StanislawStankiewicz/DefuseIt/thesis/thesis.pdf

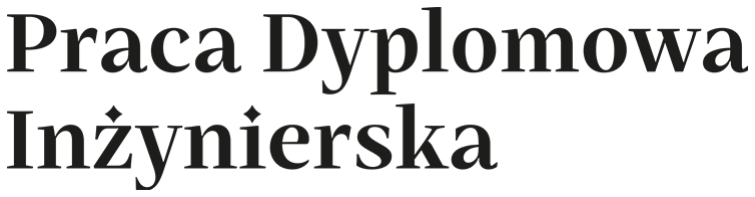
[picture p5: figure]

Stanisław Stankiewicz
217442

## Modularny system zadań logicznych zrealizowany w języku C++ dla mikrokontrolera ATmega328P

### Modular logic task system implemented in C++ language for the ATmega328P microcontroller

Praca dyplomowa na kierunku: Informatyka

Praca wykonana pod kierunkiem dra inż. Artura Wilińskiego Instytut Informatyki Technicznej Katedra Systemów Informatycznych

Warszawa, rok 2026

Oświadczenie Promotora pracy

Oświadczam, że niniejsza praca została przygotowana pod moim kierunkiem i stwierdzam, że spełnia ona warunki do przedstawienia tej pracy w postępowaniu o nadanie tytułu zawodowego.

Data | | Podpis promotora |

Oświadczenie autora pracy

Świadom/a odpowiedzialności prawnej, w tym odpowiedzialności karnej za złożenie fałszywego oświadczenia, oświadczam, że niniejsza praca dyplomowa została napisana przeze mnie samodzielnie i nie zawiera treści uzyskanych w sposób niezgodny z obowiązującymi przepisami prawa, w szczególności z ustawą z dnia 4 lutego 1994 r. o prawie autorskim i prawach pokrewnych (Dz. U. 2019 poz. 1231 z późn. zm.)

Oświadczam, że przedstawiona praca nie była wcześniej podstawą żadnej procedury związanej z nadaniem dyplomu lub uzyskaniem tytułu zawodowego.

Oświadczam, że niniejsza wersja pracy jest identyczna z załączoną wersją elektroniczną. Przyjmuję do wiadomości, że praca dyplomowa poddana zostanie procedurze antyplagiatowej.

Data | | Podpis autora pracy |

Streszczenie

Tematem pracy jest zaprojektowanie i implementacja modułowego sys-

temu interaktywnych zadań logicznych opartego na mikrokontrolerach

ATmega328P. Projekt zakładał stworzenie systemu wbudowanego sty-

mulującego współpracę grupy użytkowników rozwiązujących powiązane

zagadki pod presją czasu. Architektura umożliwia dowolną konfigurację

oraz łatwe rozszerzanie układu o kolejne niezależne moduły. Praca obej-

muje fazę koncepcyjną, projektowanie sprzętowe, implementację protokołu komunikacyjnego I²C oraz integrację oprogramowania w języku C++.

Wyniki testów wskazują, że zaimplementowane podsystemy działają sta-

bilnie, a przyjęta sieć Nadrzędny-Podrzędny (ang. Master-Slave) zapew-

nia skalowalność środowiska.

modułowy system wbudowany, C++, I2C, ATmega328P, praca inżynierska, SGGW

Słowa kluczowe – Modular logic task system implemented in C++ language for the

ATmega328P microcontroller

Summary

The subject of this thesis is the design and implementation of a modular

system of interactive logic tasks based on ATmega328P microcontrollers.

The project involved creating an embedded system that stimulates the

cooperation of a group of users solving interrelated puzzles under time

pressure. The system architecture was planned to allow for arbitrary con-

figuration and easy expansion with additional independent modules. The

thesis covers the conceptual phase, hardware design, implementation of a communication protocol based on the I²C bus, and software integration in

C++. Validation test results indicate that the implemented subsystems

exhibit stable operation, and the adopted Master-Slave network ensures

scalability of the environment.

embedded system, C++, I2C, ATmega328P, engineering thesis, WULS

Keywords –

# Spis treści

1 Wstęp | 9
2 Narzędzia i użyte technologie | 12
3 Projekt systemu zadań logicznych | 17
3.4.3 | Diagram klas warstwy sprzętowej i bibliotek zewnętrznych . . 24
4 Implementacja systemu | 26

5 Testy i działanie systemu | 47
6 Podsumowanie i wnioski końcowe | 52
Bibliografia | 54
Spis rysunków | 56
Spis tabel | 57

# 1 Wstęp

Wraz z dynamicznym rozwojem systemów wbudowanych (ang. embedded systems)

oraz postępującą miniaturyzacją sprzętu elektronicznego mikrokontrolery stały się

powszechnie dostępne dla szerokiego grona inżynierów i konstruktorów. Umożliwia-

ją one projektowanie zaawansowanych, interaktywnych urządzeń fizycznych, które

wymagają od użytkownika logicznego myślenia oraz szybkiego podejmowania decy-

zji. Istniejące na rynku rozwiązania komercyjne (wykorzystywane m.in. w pokojach

zagadek typu escape room lub w celach edukacyjno-szkoleniowych) rzadko jednak

oferują otwartą i modularną architekturę opartą na tanich, 8-bitowych mikrokon-

trolerach tworzących skalowalną sieć. Z tego powodu podjęto próbę konstrukcji au-

torskiej platformy.

## 1.1 Cel pracy

Głównym celem niniejszej pracy jest zaprojektowanie architektoniczne oraz wdroże-

nie modularnego systemu zadań logicznych. System wymusza równoległe rozwiązy-

wanie różnorodnych procedur zadaniowych przez wielu uczestników w wyznaczonym

czasie. Rozwiązanie opiera się na zdecentralizowanych interfejsach wejściowych oraz

centralnym nadzorze jednostki zarządzającej.

Temat wybrano w celu weryfikacji zagadnień związanych z programowaniem

8-bitowych mikrokontrolerów rodziny AVR, w szczególności układu ATmega328P

[1], integracją układów elektronicznych oraz implementacją niezawodnej komuni-

kacji między modułami. Konstrukcja systemu czasu rzeczywistego (ang. real-time

system) stanowi złożone zagadnienie techniczne. Wymagała ona m.in. zbudowania

warstwy transportowej opartej na magistrali I²C w celu zapewnienia bezkolizyjnej

wymiany danych pomiędzy jednostką nadrzędną, zarządzającą logiką gry, a nieza-

leżnymi węzłami wykonawczymi. Ze względu na specyfikę projektu konieczna była

optymalizacja kodu C++ pod kątem ograniczonej pamięci SRAM, której pojemność

w układach ATmega328P wynosi 2 KB.

## 1.2 Analiza istniejących rozwiązań

Projektowany system czerpie inspirację z popularnej gry kooperacyjnej Keep Talking

and Nobody Explodes, w której gracze muszą wspólnie rozbroić ładunek, komunikując

się i rozwiązując zagadki logiczne. Na rynku istnieją również komercyjne platformy

dla pokoi zagadek (np. Escape Room Master), oferujące gotowe sterowniki i oprogra-

mowanie. Jednak większość tych rozwiązań opiera się na drogich sterownikach PLC

lub mikrokomputerach typu Raspberry Pi. Niniejsza praca udowadnia, że podobną

funkcjonalność można osiągnąć przy użyciu znacznie tańszych i bardziej energoosz-

czędnych 8-bitowych mikrokontrolerów, zachowując przy tym pełną modularność i

łatwość rozbudowy.

Dodatkową wartością zaproponowanego rozwiązania jest połączenie kilku mecha-

nizmów rzadko występujących łącznie w prostych systemach AVR: automatycznego wykrywania modułów na magistrali I²C, globalnej deterministycznej konfiguracji

scenariusza gry (seed), propagacji liczby błędów do wszystkich węzłów oraz odpor-

nej na przypadkowe wyzwolenie procedury restartu.

## 1.3 Zakres pracy

Niniejsza praca inżynierska obejmuje pełen cykl projektowy i programistyczny – od

zaplanowania architektury systemu i opracowania algorytmiki oprogramowania aż

do ostatecznych testów stabilności. Wyszczególniony wykaz obszarów zadaniowych

zrealizowanych w ramach niniejszej pracy obejmuje:

- opracowanie koncepcji sprzętowej i programowej topologii rozproszonej typu

Master-Slave, wykorzystującej mikrokontrolery ATmega328P [1],

- wdrożenie biblioteki ModuleComms opartej na protokole I²C, obsługującej au-

tomatyczne wykrywanie modułów na magistrali (tzw. skanowanie adresów),

- zaprogramowanie stacji Master, odpowiedzialnej za odliczanie czasu przy uży-

ciu wielozadaniowości asynchronicznej oraz odbieranie informacji o stanie za-

dań z modułów,

- zaprogramowanie w języku C++ modułów: arytmetycznego, labiryntu (wy-

świetlacz OLED), radiowego (dekodowanie alfabetu Morse’a), sekwencyjnego

oraz modułu z przełącznikiem dźwigniowym,

- optymalizację użycia pamięci SRAM poprzez wykorzystanie pamięci Flash

(dyrektywa PROGMEM) do przechowywania danych statycznych,

- realizację testów z uwzględnieniem sprzętowej i programowej eliminacji drgań

styków (ang. debouncing).

Tak zdefiniowany zakres porządkuje dalszą strukturę pracy: w kolejnym rozdziale

przedstawiono technologie i biblioteki wykorzystane w projekcie, następnie omówio-

no założenia projektowe, implementację oraz wyniki testów.

# 2 Narzędzia i użyte technologie

W niniejszym rozdziale przedstawiono technologie, narzędzia oraz biblioteki wyko-

rzystane w niniejszej pracy. Dla każdego komponentu opisano jego rolę oraz sposób

wykorzystania. Realizacja pracy opierała się na sprawdzonych rozwiązaniach otwar-

toźródłowych (ang. open-source), co pozwoliło skupić się na logice gry zamiast na

tworzeniu sterowników od podstaw.

## 2.1 Mikrokontroler ATmega328P

ATmega328P [1] to 8-bitowy mikrokontroler z rodziny AVR, posiadający 32 KB

pamięci programu (Flash), 2 KB pamięci operacyjnej (SRAM) oraz 1 KB pamięci

danych (EEPROM). Dzięki architekturze RISC większość instrukcji wykonuje w

jednym cyklu zegara, co zapewnia dobrą wydajność przy niskim poborze energii.

Wybór tego układu podyktowany był trzema czynnikami. Po pierwsze, stanowi

on fundament popularnej platformy Arduino Uno, co daje dostęp do bardzo dużej

liczby bibliotek oraz materiałów edukacyjnych. Po drugie, oferuje natywną obsługę

peryferiów pracujących w standardzie 5 V, co eliminuje potrzebę stosowania konwerterów napięć. Po trzecie, posiada sprzętowy kontroler I²C (TWI), który jest

fundamentem komunikacji w tym systemie.

W niniejszej pracy układy pracują pod kontrolą wewnętrznego oscylatora RC

skonfigurowanego na częstotliwość 8 MHz. Wykorzystanie wbudowanego źródła sy-

gnału zegarowego, zamiast zewnętrznego rezonatora kwarcowego dostarczającego

sygnał taktujący, obniża złożoność i koszt obwodu, a jednocześnie pozwala na pra-

cę w poszerzonym zakresie napięć zasilania od 2.7 V do 5.5 V. Choć wbudowany

oscylator charakteryzuje się tolerancją wahań do ±10% (w stałych warunkach po-

kojowych błąd oscyluje w granicach ±1–2%), odchylenia te są pomijalne w kon-

tekście działania gry oraz obsługi magistrali I²C. Konfigurację niskopoziomową mi-

krokontrolera (ustawienie bitów konfiguracyjnych (ang. fuse bits), odpowiedzialnych

za trwałe ustawienia sprzętowe układu) przeprowadzono bezpośrednio przy użyciu

narzędzia wiersza poleceń avrdude, co umożliwiło precyzyjne sterowanie parame-

trami pracy układu bez użycia dodatkowych nakładek systemowych. Bezpośrednie wgrywanie oprogramowania przez złącze programowania wewnątrzsystemowego

(ang. In-System Programming — ISP) pozwoliło całkowicie wyeliminować program

rozruchowy (ang. bootloader), dzięki czemu kod programu ma do dyspozycji pełne

32 KB pamięci Flash. Jest to istotna optymalizacja względem standardowej plat-

formy Arduino Uno, w której część pamięci programu stale zajmuje wspomniany

program rozruchowy.

## 2.2 Środowisko Arduino IDE

Arduino IDE [2] to środowisko programistyczne ułatwiające tworzenie oprogramowa-

nia na mikrokontrolery. Pozwala na pisanie kodu w C++ z wykorzystaniem gotowych

bibliotek obsługujących m.in. przerwania czy komunikację.

Wybór Arduino IDE, zamiast alternatyw takich jak PlatformIO czy Atmel Stu-

dio, podyktowany był przede wszystkim dojrzałością ekosystemu bibliotek kompa-

tybilnych z platformą AVR oraz niskim progiem wejścia przy prototypowaniu. Choć

PlatformIO oferuje bardziej zaawansowane zarządzanie zależnościami, Arduino IDE

zapewniło wystarczającą funkcjonalność przy jednoczesnej prostocie konfiguracji

wielomodułowego projektu.

W ramach niniejszej pracy proces programowania układów realizowano za po-

średnictwem wspomnianego wcześniej narzędzia avrdude oraz zewnętrznego progra-

matora sprzętowego USBasp. Na potrzeby seryjnego przygotowania mikrokontrole-

rów opracowano dedykowany adapter wyposażony w gniazdo typu ZIF (ang. Zero

Insertion Force) z mechanizmem dźwigniowym. Rozwiązanie to umożliwiło szybką i

bezpieczną wymianę układów brzegowych bez ryzyka uszkodzenia ich wyprowadzeń,

zapewniając stabilne połączenie z programatorem.

## 2.3 Biblioteka komunikacji I²C – Wire.h

Wire.h [4] jest standardową biblioteką środowiska Arduino, realizującą obsługę pro-

tokołu I²C (Inter-Integrated Circuit) za pośrednictwem wbudowanego sprzętowego

kontrolera TWI mikrokontrolera ATmega328P. Biblioteka przejmuje zarządzanie re-

jestrami taktowania przesyłu, przerwaniami oraz identyfikacją sprzętową sygnałów

potwierdzających komunikację (ACK/NACK).

Protokół I²C został wybrany jako magistrala komunikacyjna systemu ze względu

na minimalizację liczby wymaganych połączeń sygnałowych — do połączenia dowolnej liczby urządzeń wystarczają zaledwie dwie linie sygnałowe (SDA i SCL) oraz

wspólne zasilanie. W porównaniu z alternatywami, takimi jak SPI (wymagający do-

datkowej linii CS dla każdego urządzenia) czy UART, I²C stanowi optymalny kom-

promis między prostotą połączeń a skalowalnością. Co istotne, protokół UART jest

interfejsem asynchronicznym, co przy braku zewnętrznego oscylatora kwarcowego i

pracy na wewnętrznym oscylatorze RC mogłoby prowadzić do błędów synchronizacji ramek przy wahaniach temperatury. Magistrala I²C, jako interfejs synchroniczny

(wykorzystujący linię zegarową SCL), jest niewrażliwa na niedokładności taktowania

mikrokontrolerów.

W niniejszej pracy biblioteka Wire.h stanowi fundament autorskiej biblioteki

ModuleComms, realizując fizyczną warstwę transportową komunikacji między jed-

nostką Master a modułami Slave.

## 2.4 Biblioteki graficzne Adafruit

Rodzina bibliotek Adafruit obejmuje Adafruit_GFX [6] — uniwersalny rdzeń gra-

ficzny 2D — oraz Adafruit_SH110X [5] — dedykowany sterownik dla wyświetlaczy

OLED opartych na układzie SH1106G.

Biblioteki te wybrano ze względu na ich szeroką kompatybilność z ekosystemem

Arduino, aktywne wsparcie społeczności oraz zoptymalizowane algorytmy rysowa-

nia, dostosowane do ograniczeń pamięciowych mikrokontrolerów 8-bitowych. Alter-

natywna biblioteka U8g2lib, choć oferuje podobną funkcjonalność, wykazuje więk-

sze zapotrzebowanie na pamięć SRAM, co stanowi istotne ograniczenie na platformie

ATmega328P dysponującej zaledwie 2 KB tego zasobu.

W niniejszej pracy biblioteki Adafruit wykorzystano w modułach labiryntu oraz

radiowym do obsługi monochromatycznych wyświetlaczy OLED o rozdzielczości

128x64 pikseli. Warstwa Adafruit_GFX umożliwia rysowanie prymitywów graficz-

nych (prostokątów, okręgów, glifów tekstowych) oraz renderowanie bitmap przecho-

wywanych w pamięci Flash za pośrednictwem dyrektywy PROGMEM, co pozwala na

obsługę dużych zasobów graficznych bez obciążania ograniczonej pamięci SRAM.

## 2.5 Biblioteka wyświetlacza LiquidCrystal

Biblioteka LiquidCrystal [3] jest standardowym narzędziem środowiska Arduino

służącym do obsługi wyświetlaczy alfanumerycznych opartych na sterowniku Hitachi HD44780. Pozwala ona na komunikację z panelem LCD w trybie 4-bitowym lub

8-bitowym, co umożliwia elastyczne zarządzanie zasobami sprzętowymi mikrokon-

trolera.

W niniejszej pracy wykorzystano tryb 4-bitowy, który wymaga podłączenia sze-

ściu linii sygnałowych (RS, EN oraz cztery linie danych). Choć rozwiązanie to zaj-

muje więcej pinów mikrokontrolera niż alternatywne interfejsy szeregowe, zapewnia

ono najwyższą wydajność odświeżania oraz pełną kompatybilność z podstawowymi

bibliotekami bez konieczności stosowania dodatkowych układów pośredniczących, takich jak ekspandery I²C. Wybór ten był możliwy dzięki rezygnacji z innych pe-

ryferiów w module arytmetycznym, co pozostawiło wystarczającą liczbę wolnych

wyprowadzeń ATmega328P. W ramach niniejszej pracy biblioteka służy do wyświe-

tlania treści zadań matematycznych oraz wprowadzanych przez użytkownika odpo-

wiedzi na panelu LCD 16x2.

## 2.6 Biblioteka TM1637Display

TM1637Display [7] jest biblioteką obsługującą sprzętowy sterownik TM1637, stoso-

wany w poczwórnych wyświetlaczach 7-segmentowych. Sterownik ten wykorzystuje dwuprzewodowy protokół komunikacyjny zbliżony koncepcyjnie do I²C, lecz wyma-

gający dedykowanych linii CLK i DIO.

Decyzja o zastosowaniu wyświetlacza TM1637 w jednostce nadrzędnej, zamiast

np. wyświetlacza OLED, podyktowana była niskim kosztem komponentu, doskona-

łą czytelnością dużych cyfr z dalszej odległości oraz minimalnym zapotrzebowaniem

na zasoby mikrokontrolera. Biblioteka realizuje transmisję danych bez stosowania

blokujących opóźnień typu delay(), co jest kluczowe dla zachowania ciągłości asynchronicznego nasłuchu na magistrali I²C w pętli głównej programu.

W niniejszej pracy wyświetlacz TM1637 pełni rolę głównego wskaźnika upływa-

jącego czasu gry w formacie MM:SS, informując uczestników o zbliżającym się jego

końcu.

## 2.7 Biblioteka interfejsu SPI

SPI.h jest standardową biblioteką środowiska Arduino, realizującą obsługę protoko-

łu Serial Peripheral Interface (SPI). Interfejs ten umożliwia szybką, synchroniczną

komunikację szeregową z peryferiami za pośrednictwem czterech linii sygnałowych:

MOSI (Master Out Slave In), MISO (Master In Slave Out), SCK (Serial Clock)

oraz CS (Chip Select).

Protokół SPI został zastosowany w module labiryntu zamiast I²C z dwóch klu-

czowych powodów. Po pierwsze, magistrala SPI oferuje znacząco wyższą przepusto-

wość, niezbędną do wydajnego przesyłania pełnych buforów ramki obrazu (1 KB) do

wyświetlacza OLED bez blokowania pętli głównej. Po drugie, mikrokontrolery ATmega328P posiadają tylko jeden sprzętowy interfejs I²C, który w tym module jest

już wykorzystywany do pracy w trybie Slave na potrzeby komunikacji systemowej.

Jednoczesna obsługa wyświetlacza jako Master na tej samej magistrali byłaby pro-

gramowo i sprzętowo nieefektywna, wymagając ciągłego i ryzykownego przełączania

trybów pracy kontrolera TWI.

# 3 Projekt systemu zadań logicznych

W niniejszym rozdziale przedstawiono projekt modularnego systemu zadań logicz-

nych. Głównym celem projektu było opracowanie skalowalnej i łatwej w rozszerzaniu

platformy sprzętowo-programowej, umożliwiającej jednoczesną, interaktywną pracę

wielu uczestników z niezależnymi modułami zagadek, koordynowanymi przez cen-

tralną jednostkę zarządzającą. W kolejnych podrozdziałach szczegółowo opisano spe-

cyfikację wymagań, architekturę systemu oraz strukturę klas obiektowych.

## 3.1 Specyfikacja wymagań

Kluczowym etapem projektu jest określenie wymagań, które system musi spełniać.

Na podstawie analizy problemu, przeglądu podobnych rozwiązań (np. w pokojach

zagadek typu escape room) oraz ograniczeń mikrokontrolerów AVR, wyodrębniono

wymagania funkcjonalne i niefunkcjonalne.

### 3.1.1 Wymagania funkcjonalne

Wymagania funkcjonalne definiują zakres operacji i możliwości, które system musi

dostarczyć użytkownikowi końcowemu. Kluczowe funkcje realizowane przez projek-

towany system zostały zestawione w Tabeli 3.1.

Tabela 3.1. Wymagania funkcjonalne systemu

Numer | Nazwa | Opis
WF-01 | Koordynacja czasu rozgrywki | Centralny węzeł Master zarządza odliczaniem czasu dla wszystkich modułów. Błędy popeł-niane przez graczy powodują przyspieszenie odliczania czasu.
WF-02 | Niezależna logika modułów zagadek | Każdy moduł posiada własny algorytm roz-wiązywania, a komunikacja z jednostką nad-rzędną odbywa się wyłącznie na żądanie węzła głównego.

Kontynuacja na następnej stronie

Tabela 3.1 – kontynuacja z poprzedniej strony

Numer | Nazwa | Opis
WF-03 | Determinizm konfi-guracji (Seed) | System inicjuje przed startem dystrybucję glo-balnego numeru konfiguracji po łączu I²C, de-terminując pseudolosowe zdarzenia we wszyst-kich układach.
WF-04 | Obsługa wielu typów modułów | System obsługuje co najmniej pięć typów mo-dułów: arytmetyczny, labiryntu, radiowy, se-kwencyjny oraz z przełącznikiem.
WF-05 | Detekcja i propaga-cja błędów | Niepoprawne działanie użytkownika generuje zdarzenie błędu rejestrowane globalnie przez Master. Akumulacja błędów wpływa na za-chowanie pozostałych modułów.
WF-06 | Automatyczne wy-krywanie topologii | Serwer Master po uruchomieniu skanuje adre-sy magistrali I²C w celu automatycznej iden-tyfikacji podłączonych modułów bez ręcznej konfiguracji.
WF-07 | Sygnalizacja dźwię-kowa i wizualna | System zapewnia eskalujące ostrzeżenia dźwiękowe oraz wizualne informujące o zbli-żającym się końcu limitu czasowego oraz o stanie błędu.
WF-08 | Mechanizm restartu z zabezpieczeniem | Restart gry wymaga trzykrotnej aktywa-cji przełącznika w ustalonym oknie czaso-wym, zapobiegając przypadkowemu zreseto-waniu rozgrywki.

Zdefiniowane wymagania kładą nacisk na samodzielność modułów przy central-

nej koordynacji. Obejmują one mechanizmy zarządzania rozgrywką (odliczanie cza-

su, błędy) oraz funkcje systemowe, takie jak automatyczne wykrywanie modułów

czy konfiguracja gry za pomocą ziarna (ang. seed).

### 3.1.2 Wymagania niefunkcjonalne

Wymagania niefunkcjonalne definiują cechy jakościowe systemu oraz techniczne ogra-

niczenia projektu. Kluczowe wymagania z tej kategorii zestawiono w Tabeli 3.2.

Tabela 3.2. Wymagania niefunkcjonalne systemu

Numer | Nazwa | Opis
WN-01 | Modularność sprzę-towa (Plug-and-Play) | Stacje podłączane są do wspólnej szyny I²C na współdzielonym zasilaniu (+5 V i GND), co ogranicza liczbę połączeń montażowych i zwiększa odporność na chwilowe przerwy w łączności.
WN-02 | Wielozadaniowość nieblokująca | Rezygnacja z wywołań delay() w logice rdze-niowej. Ocena stanów opiera się na obliczaniu różnicy czasu z wykorzystaniem systemowego stopera millis().
WN-03 | Efektywne wykorzy-stanie pamięci | System funkcjonuje w ramach limitów AT-mega328P (2 KB SRAM, 32 KB Flash). Du-że struktury danych alokowane są w pamięci Flash za pośrednictwem PROGMEM.
WN-04 | Skalowalność | Architektura umożliwia rozszerzenie o dodat-kowe moduły bez modyfikacji oprogramowa-nia Master (do 126 urządzeń na magistrali 2C). I
WN-05 | Niezawodność komu-nikacji | Protokół transportowy jest odporny na chwi-lowe zaniki łączności z pojedynczymi modu-łami bez destabilizacji pracy pozostałych wę-złów.
WN-06 | Koszt i dostępność komponentów | Projekt bazuje na tanich, powszechnie dostęp-nych komponentach elektronicznych w celu ograniczenia kosztów produkcji prototypu.
WN-07 | Stabilność zasilania | System funkcjonuje w zakresie napięć 2.7– 5.5 V, wykorzystując wewnętrzny oscylator RC 8 MHz z tolerancją wahań ±1–2%.

Wymagania te stawiają priorytet na wielozadaniowość oraz optymalizację pa-

mięci — co jest krytyczne przy zaledwie 2 KB pamięci SRAM. Istotna jest także

modularność typu Plug-and-Play, pozwalająca na dowolne podłączanie modułów

bez zmian w oprogramowaniu sterownika głównego.

## 3.2 Architektura systemu

System oparto na architekturze nadrzędno-podrzędnej (ang. Master-Slave), gdzie

centralna jednostka koordynuje pracę modułów przez magistralę I²C (Inter-Integrated

Circuit). Jest to szeregowy interfejs komunikacyjny wykorzystujący dwie linie sy-

gnałowe: SDA (Serial Data) do przesyłu danych oraz SCL (Serial Clock) do syn-

chronizacji zegarowej. Wybór tej magistrali podyktowany był jej oszczędnością w

liczbie wymaganych połączeń oraz natywnym wsparciem przez sprzętowy kontroler

TWI (Two Wire Interface) mikrokontrolera ATmega328P [1]. Zastosowanie języka

C++ pozwoliło na programowanie obiektowe z pełną kontrolą nad alokacją pamięci.

Biblioteka ModuleComms zarządza komunikacją na niskim poziomie, wykorzystując sprzętowy protokół I²C. Master inicjuje zapytania i przesyła informacje o czasie

czy błędach, natomiast klasa Slave automatycznie obsługuje te żądania po stronie

modułów. Dzięki zastosowanej abstrakcji programista modułu nie musi zajmować

się obsługą magistrali, co pozwala skupić się na samej logice zagadki. Wyróżnia się

trzy główne fazy pracy systemu:

1. Faza wykrywania (ang. Discovery): Wywołanie pętli wysyłkowej z ko-

mendą 0x07 (CMD_IDENTIFY), skanującej adresy od 1 do 126 z zapytaniem o

rzetelną odpowiedź ACK sprzętu.

2. Faza propagacji i rejestracji startu (ang. Propagation and Start):

Przeprowadzenie inicjacyjnej transakcji rozgłaszanej z flagą CMD_START_GAME.

3. Faza testowania cyklicznego stanu (ang. Run Loop): Ciągłe odpytywa-

nie modułów o ich stan logiczny, przechwytywanie zdarzeń błędu i sukcesu.

## 3.3 Konstrukcja i montaż modułów

Ważnym aspektem projektu była integracja komponentów elektronicznych w działa-

jące moduły. Każda stacja została przygotowana w sposób umożliwiający testowanie

i weryfikację założeń projektowych. Wszystkie połączenia krytyczne (zasilanie, ma-

gistrala I²C) zostały wykonane w sposób zapewniający stabilność komunikacji.

W procesie realizacji skupiono się na:

- Przygotowaniu stanowisk: Przyciski, enkoder oraz wyświetlacze zostały

połączone z mikrokontrolerami zgodnie z opracowanymi schematami.

- Zasilaniu: Całość systemu zasilana jest napięciem 5 V ze wspólnego źródła, co zapewnia kompatybilność z mikrokontrolerami ATmega328P.
- Integracji peryferiów: Każdy moduł posiada dedykowany zestaw elementów

(np. matryce LED, ekrany LCD/OLED) ściśle współpracujących z warstwą

oprogramowania.

## 3.4 Diagramy klas

W niniejszej sekcji przedstawiono diagramy klas dokumentujące strukturę obiektową

zaprojektowanego systemu. Diagramy opracowano zgodnie z notacją UML 2.0.

### 3.4.1 Diagram klas biblioteki ModuleComms

W celu sformalizowania struktury oprogramowania oraz ułatwienia procesu imple-

mentacji, posłużono się notacją UML (Unified Modeling Language). Diagram klas

jest diagramem strukturalnym, przedstawiającym system za pomocą wizualizacji

atrybutów, metod oraz relacji pomiędzy klasami. Jest on powszechnie stosowanym

narzędziem w projektowaniu systemów opartych na programowaniu obiektowym.

Centralnym elementem architektury komunikacyjnej jest autorska biblioteka

ModuleComms, której strukturę obiektową przedstawiono na Rysunku 3.1. Diagram

prezentuje dwie główne klasy — Master oraz Slave — wraz z typami pomocniczymi

definiującymi protokół komunikacyjny.


Rysunek 3.1. Diagram klas biblioteki ModuleComms — relacja Master-Slave z protokołem komunikacyjnym (opracowanie własne)

Diagram klas przedstawia strukturę autorskiej biblioteki komunikacyjnej, w tym

klasy Master (odpowiadającą za jednostkę nadrzędną) oraz Slave (reprezentującą

podległe moduły), a także powiązane z nimi typy wyliczeniowe Protocol i Status.

Implementacja wykorzystuje mechanizm wstrzykiwania funkcji zwrotnych (wskaź-

niki GameLoop i ResetState), co pozwala na pełną separację warstwy sieciowej od

logiki biznesowej konkretnych zadań. Metoda getModuleStatus() umożliwia odczyt

stanu poszczególnych węzłów.

Klasa Slave reprezentuje stronę odbiorczą protokołu. Wykorzystuje statyczne

pola i metody ze względu na ograniczenia biblioteki Wire.h, która wymaga rejestra-

cji funkcji zwrotnych w postaci wskaźników na funkcje wolnostojące. Wstrzykiwanie

logiki gry odbywa się przez wskaźniki funkcyjne GameLoop oraz ResetState, prze-

kazywane w konstruktorze — stanowi to realizację wzorca odwrócenia sterowania

(ang. Inversion of Control), umożliwiającą każdemu modułowi zagadki dostarczenie

własnej implementacji pętli gry bez modyfikacji kodu biblioteki komunikacyjnej.

Typy wyliczeniowe Protocol oraz Status definiują zestaw jednobajtowych kodów operacyjnych (opcodes) przesyłanych na magistrali I²C, zapewniając jedno-

znaczną interpretację ramek komunikacyjnych po obu stronach łącza.

### 3.4.2 Diagram klas modułów zagadek

Każdy moduł zagadki w systemie stanowi niezależną jednostkę logiczną, integrowaną

z magistralą komunikacyjną poprzez instancję klasy Slave z biblioteki ModuleComms.

Diagram przedstawiony na Rysunku 3.2 ilustruje strukturę pięciu zaimplementowa-

nych modułów wraz z ich wewnętrznymi typami danych.


Rysunek 3.2. Diagram klas modułów zagadek z wewnętrznymi typami wyliczeniowymi i strukturami danych (opracowanie własne)

Wspólnym elementem architektury wszystkich modułów jest mechanizm wstrzy-

kiwania funkcji zwrotnych (ang. callbacks) — każdy moduł przekazuje w konstruk-

torze klasy Slave wskaźniki na swoje funkcje gameLoop() oraz resetState(), re-

alizując wzorzec odwrócenia sterowania (ang. Inversion of Control). Dzięki temu

klasa Slave wywołuje logikę specyficzną dla danego modułu bez znajomości jej im-

plementacji.

Moduły różnią się znacząco pod względem złożoności wewnętrznej. Moduł se-

kwencyjny wykorzystuje maszynę stanów (enum GameState) do zarządzania fa-

zami rozgrywki, natomiast moduł z przełącznikiem operuje na typach wyliczenio-

wych ActionType i ColorId definiujących logikę decyzyjną opartą na kolorze diody

RGB i numerze wersji gry. Moduł arytmetyczny implementuje dwa tryby pracy

(enum Mode: arytmetyczny i binarny), a moduł radiowy przechowuje tablicę struk-

tur RadioTarget z częstotliwościami i kodami Morse’a w pamięci Flash (PROGMEM).

### 3.4.3 Diagram klas warstwy sprzętowej i bibliotek zewnętrz-

### nych

Ostatni z diagramów (Rysunek 3.3) przedstawia mapę zależności pomiędzy moduła-

mi systemu a wykorzystywanymi bibliotekami zewnętrznymi. Diagram uwidacznia,

w jaki sposób poszczególne węzły korzystają ze współdzielonych komponentów pro-

gramowych.


Rysunek 3.3. Diagram zależności warstwy sprzętowej — powiązania modułów z bibliotekami zewnętrznymi (opracowanie własne)

Centralnym elementem jest biblioteka ModuleComms, z której korzystają wszyst-

kie węzły systemu — zarówno Master (klasa Master), jak i moduły zagadek (klasa

Slave). Komunikacja realizowana jest za pośrednictwem biblioteki Wire.h, stano-

wiącej warstwę abstrakcji nad sprzętowym kontrolerem I²C.

Moduły radiowy oraz labiryntu wykorzystują dodatkowo sterownik wyświetla-

czy OLED Adafruit_SH1106G, który dziedziczy po uniwersalnym rdzeniu graficz-

nym Adafruit_GFX i komunikuje się z wyświetlaczem przez interfejs SPI (SPI.h).

Moduł arytmetyczny korzysta z biblioteki LiquidCrystal do obsługi panelu alfa-

numerycznego LCD, natomiast jednostka nadrzędna wykorzystuje TM1637Display

do sterowania wyświetlaczem 7-segmentowym prezentującym czas rozgrywki. Mo-

duł sekwencyjny oraz moduł z przełącznikiem nie wymagają zewnętrznych bibliotek

peryferiów — operują wyłącznie na pinach cyfrowych mikrokontrolera za pomocą

standardowych funkcji Arduino.

# 4 Implementacja systemu

W niniejszym rozdziale opisano praktyczną realizację założeń projektowych syste-

mu. Nacisk położono na architekturę oprogramowania, implementację autorskiego

protokołu komunikacyjnego, zastosowany wzorzec wielozadaniowości kooperatywnej

oraz szczegółową budowę poszczególnych modułów zagadek. Dla każdego kompo-

nentu przedstawiono kluczowe fragmenty kodu źródłowego wraz z uzasadnieniem

przyjętych rozwiązań programistycznych.

## 4.1 Architektura oprogramowania

Zaprojektowany system działa w architekturze silnie rozproszonej ze scentralizo-

waną jednostką nadrzędną. Jeden koordynujący serwer (Master) nadzoruje liczne

moduły podrzędne (Slave), a warstwa oprogramowania ujednolica sposób wymiany

informacji o stanie poszczególnych węzłów. Podczas projektowania struktury progra-

mu przyjęto założenie, że logika centralna ma być odseparowana od implementacji

konkretnych modułów i ich czujników oraz elementów wykonawczych.

## 4.2 Autorska biblioteka komunikacyjna Module-

## Comms

Biblioteka ModuleComms powstała, aby ujednolicić obsługę komunikacji I²C i ogra-

niczyć powielanie kodu. Bez niej każdy moduł musiałby samodzielnie zarządzać

buforowaniem danych i dekodowaniem ramek protokołu. Biblioteka przejmuje te

zadania, udostępniając funkcje do sprawdzania stanu modułów i obsługi logiki gry.

W protokole komunikacyjnym każde polecenie i każdy status to pojedynczy

bajt. Komendy wywołujące akcję po stronie serwera to np. CMD_START_GAME czy

CMD_IDENTIFY, a flagi stanu modułu to STATUS_UNSOLVED, STATUS_PASSED

i STATUS_FAILED. Dzięki temu zamiast przesyłać przez magistralę pełne tekstowe

identyfikatory poleceń wystarczy pojedynczy bajt — co zmniejsza liczbę przesyła-

nych danych i zwiększa przepustowość komunikacji. Listing 4.1 prezentuje komplet

kodów komend i statusów używanych przez warstwę transportową biblioteki.

1 | # define CMD_START_GAME | 0 x01
2 | # define CMD_END_GAME | 0 x02
3 | # define CMD_GET_STATUS | 0 x03
4 | # define CMD_SET_STATUS | 0 x04
5 | # define CMD_GET_VERSION | 0 x05
6 | # define CMD_SET_VERSION | 0 x06
7 | # define CMD_IDENTIFY | 0 x07
8 | # define CMD_SET_REMAINING_SECONDS 0 x08
9 | # define CMD_SET_MISTAKE_COUNT | 0 x09
10 | # define CMD_UNKNOWN | 0 xFF

11
12 | # define STATUS_UNSOLVED 0 x01
13 | # define STATUS_PASSED | 0 x02
14 | # define STATUS_FAILED | 0 x03

Listing 4.1. Definicje protokołu transportowego I²C w bibliotece ModuleComms

Biblioteka udostępnia dwie główne klasy: Master — dla jednostki nadrzędnej —

oraz Slave — dla modułów podrzędnych.

Klasa Master odpowiada za koordynację systemu: skanuje magistralę

w | poszukiwaniu | modułów | (discoverModules()), | przesyła | pozostały
czas | gry | (sendRemainingSeconds()) | oraz | rozgłasza | liczbę | błędów

(broadcastMistakeCount()). Wykaz adresów modułów przechowywany jest w ta-

blicy, co eliminuje potrzebę dynamicznej alokacji pamięci.

Listing 4.2 pokazuje publiczny interfejs klasy Master, odpowiedzialnej za orkie-

strację rozgrywki.

class Master {

public :

Master ( uint8_t version ) ;

void begin () ;

void discoverModules () ;

void startGame () ;

void endGame () ;

void restartFailedModule ( uint8_t index ) ;

// Obieg stanu i propagacja zmiennych gry do wbudowanych

zagadek

uint8_t getModuleStatus ( uint8_t index ) ;

void sendRemainingSeconds ( uint8_t moduleAddress , uint16_t

remainingSeconds ) ;

void broadcastMistakeCount ( uint8_t mistakeCount ) ;

void sendCommand ( uint8_t moduleAddress , uint8_t command ) ;

private :

uint8_t version ;

uint8_t moduleAddresses [11];

uint8_t moduleCount ;

};

Listing 4.2. Interfejs główny platformy nadzorującej (ModuleComms.h)

Dzięki takiej architekturze Master nie musi znać szczegółów działania poszcze-

gólnych modułów. Każdy z nich jest traktowany jako „czarna skrzynka”, która zwra-

ca jedynie informację o swoim stanie: sukces, błąd lub oczekiwanie.

Integracja modułu z biblioteką polega na przekazaniu dwóch funkcji: gameLoopFn

(logika zagadki) oraz resetStateFn (powrót do stanu początkowego). Jest to reali-

zacja wzorca odwrócenia sterowania (ang. Inversion of Control) — moduł dostarcza

kod, a biblioteka decyduje o momencie jego wywołania. Programista musi jedynie

wywołać slave.slaveLoop() w głównej pętli Arduino.

Listing 4.3 zawiera uproszczony interfejs klasy Slave wraz z funkcjami zwrotny-

mi.

typedef void (* GameLoop ) () ;

typedef void (* ResetState ) () ;

class Slave {

public :

Slave ( uint8_t address , GameLoop loop , ResetState setState ,

uint8_t pin ) ;

void begin () ;

// Obs ługa niewidocznych funkcji wejścia:

void slaveLoop () ;

// Publiczne emitery aktualizuj ące stan logiczny flag na

maszynie stan ów

void pass () ;

void fail () ;

// Aktualizacje rozproszone przetrzymuj ące pozycj ę z serwera

uint8_t getVersion () ;

uint16_t getRemainingSeconds () ;

uint8_t getMistakeCount () ;

private :

static GameLoop gameLoop ;

static ResetState resetState ;

// Niskopoziomowy dost ęp odczytu sprz ę towego z podpi ęcia \

texttt { Wire .h}

static void receiveEvent (int numBytes ) ;

static void requestEvent () ;

};

Listing 4.3. Uproszczona definicja interfejsu polimorficznego do węzłów łamigłówek (ModuleComms.h)

Jednostka Master zarządza komunikacją poprzez cykliczne odpytywanie wszyst-

kich modułów podłączonych do magistrali. Wykorzystuje do tego funkcję

Wire.requestFrom(), która umożliwia odczyt statusu z każdego węzła. Jeżeli mo-

duł zgłosi stan STATUS_PASSED, Master przestaje go odpytywać, uznając zadanie za

wykonane. W przypadku zgłoszenia STATUS_FAILED licznik błędów systemu zostaje

zwiększony. Po przekroczeniu dopuszczalnej liczby błędów lub upływie czasu Master

wysyła do wszystkich modułów sygnał zakończenia gry, co powoduje zablokowanie ich logiki i wywołanie funkcji resetującej stan urządzenia.

## 4.3 Wielozadaniowość kooperatywna i wstrzyma-

## nia nieblokujące

Standardowe podejście w środowisku Arduino do odmierzania czasu opiera się na

funkcji delay(). Skutkuje ona jednak zatrzymaniem pracy procesora na określo-

ny czas (ang. busy waiting), co uniemożliwia wykonywanie innych zadań w tle. Ze

względu na asynchroniczny model komunikacji I²C stosowany w niniejszej pracy,

użycie blokującego oczekiwania doprowadziłoby do utraty nadchodzących pakietów

danych i żądań ze sterownika Master, co skutkowałoby błędami desynchronizacji

(ang. timeout).

Aby zagwarantować pełną responsywność systemu i uniknąć kolizji na magi-

strali, wdrożono wzorzec wielozadaniowości kooperatywnej (ang. cooperative

multitasking). Zamiast zatrzymywać program, wykorzystano nieblokujące liczniki

programowe (ang. non-blocking software timers) oparte na funkcji millis(). We

wszystkich modułach główna pętla loop() wykonuje się nieustannie, a logika pro-

gramu jedynie sprawdza, czy od ostatniego zdarzenia upłynął wymagany interwał

czasowy. Pozwala to mikrokontrolerowi na jednoczesne odświeżanie wyświetlaczy, skanowanie przycisków oraz ciągłe nasłuchiwanie na magistrali I²C bez ryzyka za-

blokowania komunikacji.

## 4.4 Implementacja obwodów i modułów wbudo-

## wanych

### 4.4.1 Adresacja i topologia modułów

W implementacji systemu każdy moduł otrzymał stały adres magistrali I²C, co

pozwala na jednoznaczną identyfikację urządzeń już na etapie inicjalizacji oraz eli-

minuje ryzyko kolizji adresów. Rozwiązanie to upraszcza procedurę wykrywania,

ułatwia diagnostykę i zwiększa rozszerzalność systemu, ponieważ dodanie nowego

modułu sprowadza się do przydzielenia mu wolnego adresu i nie wymaga dodatko-

wej ingerencji po stronie modułu nadrzędnego. Taka forma adresacji jest również

korzystna z punktu widzenia czytelności kodu i organizacji całej topologii logicznej.

Przyjęto następujące przypisanie adresów do modułów, zestawione w Tabeli 4.1:

Tabela 4.1. Przypisanie adresów I²C do modułów systemu

Adres | Moduł
0x11 | Moduł sekwencyjny
0x12 | Moduł labiryntu
0x13 | Moduł radiowy
0x14 | Moduł z przewodami
0x15 | Moduł symboli

### 4.4.2 Moduł nadrzędny

Stacja nadrzędna stanowi centralny punkt decyzyjny całego omawianego systemu.

Jako jedyna z peryferiów, nie implementuje ona podrzędnego interfejsu zagadek,

lecz służy za główny zegar odliczający i dystrybutor globalnych ustawień gry. Stacja

nadrzędna została rozbudowana o poczwórny wyświetlacz 7-segmentowy (TM1637),

pełniący rolę głównego wskaźnika czasu, oraz dodatkowy, 2-cyfrowy wyświetlacz 7-

segmentowy obsługiwany przez rejestry przesuwne. Ten drugi służy do prezentacji

wylosowanego ziarna pseudolosowości (zmiennej version), determinującego logikę

pozostałych modułów. Interfejs wyposażono również w przycisk Start, przełącznik

dźwigniowy oraz przetwornik piezoelektryczny (buzzer) do sygnalizacji dźwiękowej.

Mikrokontroler reguluje tempo narastających ostrzeżeń dźwiękowych. Stabilność

tego modułu opiera się na nieblokującej funkcji handleBeeps(), której algorytm wy-

znacza odstępy między sygnałami w oparciu o różnicę między pozostałym czasem gry

a progiem krytycznym (steadyBeepThreshold). Gdy rezerwa czasu spadnie poniżej

progu, sygnał staje się ciągły. Wykorzystano do tego wartość zmiennoprzecinkową

progress, która estymuje wymagany sukcesywny spadek interwału beepInterval.

Dzięki rezygnacji z instrukcji delay(), Master zachowuje pełną responsywność na pakiety przychodzące z magistrali I²C.

Listing 4.4 przedstawia implementację funkcji handleBeeps(), która dynamicz-

nie skraca interwał sygnałów ostrzegawczych.

void handleBeeps () {

if ( millis () - lastBeepTime >= beepInterval ) {

beep () ;

lastBeepTime = millis () ;

// Kalkulacja przyspieszania odst ępów w miar ę upływu czasu

if ( remainingTime > steadyBeepThreshold ) {

float progress = float ( remainingTime - steadyBeepThreshold )

/ float ( gameDurationSeconds -

steadyBeepThreshold ) ;

beepInterval = finalInterval + ( initialInterval -

finalInterval ) * progress ;

} else {

beepInterval = finalInterval ; // Sygna ł ciągły po

przekroczeniu progu

}

}

}

Listing 4.4. Nieblokująca obsługa przyspieszonego upływu czasu ostrzegawczego (Master.ino)

Ważnym elementem zabezpieczającym obsługę przełącznika jest funkcja handle

Switch(). Aby zapobiec przypadkowemu przerwaniu rozgrywki, wdrożono mecha-

nizm potwierdzenia resetu. Operator (wyłącznie w celach diagnostycznych) musi

trzykrotnie przełączyć dźwignię w krótkim odstępie czasu, zdefiniowanym przez

SWITCH_RESET_TIMEOUT, aby wywołać procedurę resetGame() i przywrócić system

do stanu gotowości.

Listing 4.5 ilustruje licznik okna czasowego używany do bezpiecznego potwier-

dzania resetu.

void handleSwitch () {

bool currentSwitchState = ( digitalRead ( SWITCH_PIN ) == LOW ) ;

if ( currentSwitchState != isSwitchOn ) {

isSwitchOn = currentSwitchState ; // Detekcja przerzucenia prądu

na prze łą czniku

if (! isSwitchOn ) {

unsigned long currentTime = millis () ;

// Zliczanie prób na oknie reset ów

if ( currentTime - lastSwitchOffTime < SWITCH_RESET_TIMEOUT ) {

switchOffCount ++;

if ( switchOffCount >= 3) {

resetGame () ; // Resetowanie gry i powiadomienie modu łów

Slave

switchOffCount = 0;

}

} else {

switchOffCount = 1;

}

lastSwitchOffTime = currentTime ;

} else {

if (! isGameInProgress ) startGame () ;

}

}

}

Listing 4.5. Programowe ubezpieczenie przed przypadkowym restartem gry z licznikiem czasowym operacji (Master.ino)

Kluczowa dla przebiegu gry jest funkcja checkModules(), która odpowiada za

sprawdzenie warunków zwycięstwa lub porażki. Master sekwencyjnie pobiera statu-

sy ze wszystkich zarejestrowanych modułów (STATUS_PASSED, STATUS_FAILED lub

STATUS_UNSOLVED). Na tej podstawie system decyduje, czy cała zagadka została

rozwiązana, czy też należy zarejestrować błąd popełniony przez graczy.

Listing 4.6 pokazuje pętlę odpytywania modułów i priorytetowe przechwytywanie

stanu błędu.

void checkModules () {

areAllModulesSolved = true ;

failedModuleIndex = -1;

for ( uint8_t i = 0; i < master . getModuleCount () ; i ++) {

uint8_t status = master . getModuleStatus ( i ) ;

// Jedyna definicja sukcesu dla całego urzą dzenia : wszystkie zg

ł aszaj ą PASS

if ( status != STATUS_PASSED ) {

areAllModulesSolved = false ;

}

// Przechwytywanie błędu jako absolutny priorytet iteracji

if ( status == STATUS_FAILED ) {

failedModuleIndex = i ;

break ;

}

}

}

Listing 4.6. Procedura odpytywania stacji na nasłuchu I²C (Master.ino)

Główna logika sterownika Master znajduje się w pętli loop(). Gdy gra trwa

(isGameInProgress), system zarządza czterema kluczowymi zadaniami: odlicza-

niem czasu (updateGameTimer()), sygnalizacją dźwiękową (handleBeeps()), obsłu-

gą diody błędu (handleMistakeBlinking()) oraz cyklicznym sprawdzaniem statusu

podłączonych urządzeń. Funkcja handleMistakeBlinking() informuje o liczbie błę-

dów poprzez serię błyśnięć czerwonej diody LED powtarzaną co 5 sekund. W przy-

padku wykrycia awarii modułu, Master uruchamia procedurę handleFailure(),

która sygnalizuje błąd dźwiękiem i resetuje dany moduł, pozwalając na ponowne

rozwiązanie zagadki.

Listing 4.7 przedstawia kompletną pętlę główną jednostki nadrzędnej z podzia-

łem na zadania cykliczne.

1 | void loop () {
2 | handleSwitch () ; | // Odczyt statusu zasilania / restartu
3 | handleButton () ; | // Manualne uruchomienie po starcie

4
5 | if ( isGameEnded && ! isSwitchOn ) {
6 | resetGame () ;
7 | isGameEnded = false ;
8 | }

9
10 | if ( isGameInProgress ) {
11 | updateGameTimer () ;
12 | handleBeeps () ;
13 | handleMistakeBlinking () ;

14
15 | if ( isHandlingFailure ) {
16 | handleFailure () ; // Procedura pauzuj ąca wymuszona błę dnym

stanem modu łu

17 | } else {
18 | checkModules () ; | // Aktualizacja stanu wszystkich modu łów
19 | checkWinLose () ; | // Weryfikacja warunk ów końca gry
20 | }

21
22 | delay (50) ; // Bufor mityguj ący zapchanie magistrali I2C
23 | }
24 | }

Listing 4.7. Główna pętla sterująca jednostki nadrzędnej (Master.ino)

### 4.4.3 Moduł sekwencyjny

Implementuje klasyczną łamigłówkę typu Simon Mówi, w której gracz musi zapa-

miętać i bezbłędnie odwzorować rosnącą sekwencję sygnałów świetlno-dźwiękowych.

Warstwa sprzętowa modułu opiera się na czterech przyciskach mechanicznych przy-

pisanych do kolorów oraz przetworniku piezoelektrycznym. Przebieg rozgrywki po-

dzielono na fazy prezentacji (SHOWING) oraz oczekiwania na wejście (WAITING_INPUT),

zarządzane przez maszynę stanów.

Kluczowym mechanizmem utrudniającym zadanie jest dynamiczne przypisywa-

nie kolorów przycisków w zależności od aktualnej liczby błędów popełnionych w

całej grze. Funkcja mapColorByMistakes() sprawia, że ten sam kolor sygnału może wymagać naciśnięcia innego przycisku w miarę narastania presji czasu i liczby pomyłek przesyłanych magistralą I²C.

Koordynacja stanów gry odbywa się wewnątrz funkcji gameLoop(), która w każ-

dym cyklu procesora sprawdza aktualny etap rozgrywki i wywołuje odpowiednie

procedury obsługi prezentacji sekwencji lub odczytu wejść.

Listing 4.8 ilustruje przejścia maszyny stanów pomiędzy fazami rundy modułu

sekwencyjnego.

void gameLoop () {

switch ( currentState ) {

3 | case UNENGAGED : | handleUnengaged () ; | break ;
4 | case SHOWING : | handleShowing () ; | break ;

case WAITING_INPUT : handleWaitingInput () ; break ;

| case ROUND_CLEAR :

if ( millis () - stateTimer >= WAIT_AFTER_CORRECT ) {

showIndex = 0;

inputIndex = 0;

currentState = SHOWING ;

stateTimer = millis () ;

| }
| break ;

}

}

Listing 4.8. Główna pętla logiczna modułu sekwencyjnego (SimonSays.ino)

Implementacja ta pozwala na zachowanie ciągłej łączności z jednostką Master

przy jednoczesnej obsłudze animacji diod oraz sygnałów dźwiękowych.

Listing 4.9 pokazuje reguły mapowania kolorów przycisków zależnie od liczby

błędów globalnych.

int mapColorByMistakes (int shownColor , uint8_t mistakeCount ) {

if ( shownColor < 0 || shownColor > 3) return shownColor ;

if ( mistakeCount == 0) {

const int map0 [4] = { BLUE , RED , GREEN , YELLOW };

return map0 [ shownColor ];

}

if ( mistakeCount == 1) {

const int map1 [4] = { YELLOW , GREEN , BLUE , RED };

return map1 [ shownColor ];

}

const int map2plus [4] = { GREEN , YELLOW , RED , BLUE };

return map2plus [ shownColor ];

}

Listing 4.9. Dynamiczne przypisywanie układu klawiszy w zależności od liczby błędów (SimonSays.ino)

### 4.4.4 Moduł arytmetyczny

Realizuje łamigłówkę matematyczną, w której zadaniem gracza jest rozwiązanie pro-

ceduralnie generowanego zadania i wprowadzenie wyniku za pomocą klawiatury.

Warstwa sprzętowa modułu składa się z 16-klawiszowej klawiaturze membranowej

w topologii matrycowej oraz alfanumerycznego wyświetlacza LCD 16x2. W przeciwieństwie do założeń wykorzystujących adapter I²C, w ostatecznej implementacji

zdecydowano się na bezpośrednie sterowanie równoległe (6 linii sterujących), co po-

zwoliło na uproszczenie warstwy programowej kosztem wykorzystania większej liczby

pinów mikrokontrolera (od D11 do A2).

Główna pętla gry gameLoop() zarządza stanem wyświetlacza, czasem oczekiwa-

nia po błędzie oraz interpretacją wejść z klawiatury.

Listing 4.10 przedstawia przebieg pętli głównej modułu arytmetycznego wraz z

kontrolą pauzy po błędzie.

void gameLoop () {

// Obs ługa wymuszonej pauzy po pope ł nieniu błędu

if ( waitingAfterMistake ) {

if ( millis () >= nextEquationAt ) {

waitingAfterMistake = false ;

generateEquation () ;

} else {

return ;

}

}

// Odświe ż enie interfejsu przy zmianie zadania

if ( updateDisplay ) {

lcd . clear () ;

lcdPrintLine (0 , ( currentMode == BINARY ) ? lastBinary :

currentEquation ) ;

updateDisplay = false ;

}

// Skanowanie wej ść od gracza

char key = scanKeypad () ;

if ( key != ’\0 ’) {

handleKey ( key ) ; // Rozpoznawanie liczb i znak ów funkcyjnych

}

}

Listing 4.10. Główna pętla logiczna modułu arytmetycznego (Keypad.ino)

Algorytm generuje zadania w dwóch trybach (ustalanych na podstawie global-

nej zmiennej version): arytmetycznym (podstawowe działania matematyczne) oraz

binarnym (konwersja liczb dziesiętnych na binarne). Wdrożenie obsługi wejścia wy-

magało precyzyjnego mechanizmu eliminowania drgań styków (ang. debouncing),

aby uniknąć rejestrowania wielokrotnych naciśnięć tego samego klawisza.

Listing 4.11 zawiera implementację programowego debouncera dla matrycy kla-

wiatury.

char scanKeypad () {

char rawKey = scanRawKeypad () ; // Odczyt sprz ę towy matrycy

unsigned long now = millis () ;

// Detekcja zmiany stanu klawisza

if ( rawKey != lastRawKey ) {

lastRawKey = rawKey ;

keyLastChangeAt = now ;

}

// Filtrowanie drga ń styk ów ( ignorowanie szybkich oscylacji )

if ( now - keyLastChangeAt < KEYPAD_DEBOUNCE_MS ) {

return ’\0 ’;

}

// Rejestracja stabilnego wciśnięcia

if ( rawKey != debouncedKey ) {

debouncedKey = rawKey ;

if ( debouncedKey == ’\0 ’) {

keyReported = false ; // Reset po puszczeniu klawisza

}

}

// Jednorazowe zgł oszenie naci śnięcia do logiki gry

if ( debouncedKey != ’\0 ’ && ! keyReported ) {

keyReported = true ;

return debouncedKey ;

}

return ’\0 ’;

}

Listing 4.11. Nieblokujący odczyt klawiatury z programowym debouncingiem (Keypad.ino)

### 4.4.5 Moduł z przełącznikiem

Realizuje prostą, lecz wymagającą precyzji zagadkę, w której zadaniem gracza jest

wykonanie właściwej akcji na fizycznym przełączniku dźwigniowym w oparciu o

aktualny kolor podświetlenia diody RGB. W zależności od koloru i numeru wersji

rozgrywki (version), moduł oczekuje jednej z dwóch akcji: szybkiego przełączenia

(Click) lub przytrzymania przełącznika (Hold) do momentu wystąpienia konkretnej

cyfry na liczniku głównym.

Koordynację stanów modułu realizuje funkcja gameLoop(), która monitoruje fi-

zyczny stan pinu wejściowego i w zależności od wybranego trybu wywołuje procedury

przetwarzające czas trwania interakcji.

Listing 4.12 przedstawia logikę wyboru procedury Click/Hold w pętli modułu z

przełącznikiem.

void gameLoop () {

// Inicjalizacja wyzwania przy starcie lub po resecie

if (! challengeArmed ) {

armChallenge () ;

return ;

}

int currentState = digitalRead ( SWITCH_PIN ) ;

// Wyb ór procedury weryfikacji w zale żności od trybu

if ( activeAction == ACTION_CLICK ) {

processClick ( currentState ) ;

} else {

processHold ( currentState ) ;

}

}

Listing 4.12. Główna pętla logiczna modułu z przełącznikiem (Switch.ino)

W przypadku akcji Hold, dioda RGB zmienia kolor w momencie aktywacji prze-

łącznika, podpowiadając graczowi moment zwolnienia dźwigni. Użytkownik musi

puścić przełącznik w chwili, gdy ostatnia cyfra odliczanego przez Mastera czasu gry

zgadza się z wartością przypisaną do danego koloru (np. cyfra 4 dla koloru niebie-

skiego).

Listing 4.13 pokazuje reguły decyzyjne przypisujące akcję do kombinacji koloru

i wersji rozgrywki.

ActionType determineAction ( ColorId color , uint8_t version ) {

if ( color == COLOR_GREEN ) return ACTION_CLICK ;

// Logika warunkowa oparta na parzysto ści wersji

if (( color == COLOR_RED || color == COLOR_BLUE ) && ( version % 2

== 0) ) {

return ACTION_CLICK ;

}

if (( color == COLOR_BLUE || color == COLOR_YELLOW ) && ( version

% 3 == 0) ) {

return ACTION_HOLD ;

}

if ( color == COLOR_YELLOW && ( version % 2 == 0) && ( version % 3

== 0) ) {

return ACTION_CLICK ;

}

return ACTION_HOLD ; // Domy ś lnie wymagane przytrzymanie

}

Listing 4.13. Wyznaczanie poprawnej procedury działania w oparciu o stan gry (Switch.ino)

### 4.4.6 Moduł labiryntu

Implementuje przestrzenną łamigłówkę nawigacyjną, w której gracz porusza się we-

wnątrz wirtualnego labiryntu za pomocą trzech przycisków (ruch na wprost oraz ob-

roty w prawo lub w lewo). Interfejs graficzny oparto na wyświetlaczu OLED 128x64

pikseli. Co istotne, w przeciwieństwie do innych modułów, system ten komunikuje

się z ekranem za pomocą szybkiej magistrali SPI (piny MOSI, CLK, CS, DC, RST).

Wybór tego standardu zamiast I²C podyktowany był nie tylko wyższą przepusto-

wością niezbędną do odświeżania pełnoekranowych bitmap, ale przede wszystkim

ograniczeniem sprzętowym mikrokontrolera. ATmega328P posiada tylko jeden interfejs I²C, który w tym przypadku musi stale pracować w trybie Slave, by odbierać

komendy od Mastera. Równoczesne pełnienie roli Mastera dla wyświetlacza byłoby

na tym układzie praktycznie niemożliwe.

Logika modułu opiera się na współdzieleniu funkcji canMove() zarówno do wa-

lidacji przemieszczeń gracza, jak i do dynamicznego generowania rzutu perspekty-

wicznego. Sercem koordynacji jest funkcja gameLoop(), która w sposób nieblokujący zarządza stanem wejść i wyjść.

Listing 4.14 przedstawia nieblokującą obsługę wejść użytkownika i renderowania

widoku labiryntu.

1 | void gameLoop () {
2 | // Pierwszorz ędne narysowanie widoku po starcie gry
3 | if ( needsInitialRender ) {
4 | renderView () ;
5 | needsInitialRender = false ;
6 | }
7 | // Odczyt stan ów przycisk ów steruj ą cych
8 | bool btnLeft | = digitalRead ( BTN_LEFT ) ;
9 | bool btnForward = digitalRead ( BTN_FORWARD ) ;
10 | bool btnRight | = digitalRead ( BTN_RIGHT ) ;

11
12 unsigned long currentMillis = millis () ;

13
14 | // Obs ługa wej ścia z programowym debouncingiem
15 | if ( currentMillis - lastInputTime >= INPUT_DELAY ) {
16 | if (! btnForward && lastBtnForward ) {
17 | lastInputTime = currentMillis ;
18 | if ( moveForward () ) {
19 | display . clearDisplay () ; // Czyszczenie po wygranej
20 | display . display () ;
21 | return ;
22 | }
23 | renderView () ;
24 | }
25 | else if (! btnLeft && lastBtnLeft ) {
26 | lastInputTime = currentMillis ;
27 | turnLeft () ;
28 | renderView () ;
29 | }
30 | else if (! btnRight && lastBtnRight ) {
31 | lastInputTime = currentMillis ;
32 | turnRight () ;
33 | renderView () ;
34 | }
35 | }
36 | // Zapami ę tanie stan ów do detekcji zbocza
37 | lastBtnLeft | = btnLeft ;
38 | lastBtnForward = btnForward ;
39 | lastBtnRight | = btnRight ;
40 | }

Listing 4.14. Główna pętla logiczna modułu labiryntu (Labyrinth.ino)

Warstwa wizualna budowana jest z przeskalowanych bitmap definiujących ściany

w | różnej | odległości | i | perspektywie. | Wszystkie | elementy | graficzne

(np. epd_bitmap_closed_left_far) przechowywane są w pamięci Flash za pomocą

dyrektywy PROGMEM. Każda bitmapa o wymiarach 128x64 piksele zajmuje 1024 baj-

ty (1 KB) pamięci nieulotnej, gdzie pojedynczy bajt definiuje stan ośmiu sąsiednich

pikseli w poziomie. Dzięki takiemu podejściu, mimo że zbiór grafik waży aż 15 KB,

moduł mieści się w pamięci ATmega328P, rezerwując jedynie niezbędny stały bu-

for ramki (1 KB) w pamięci operacyjnej SRAM. Moduł zajmuje 28234 bajty (87%)

Flash oraz 792 bajty (38%) SRAM.

### 4.4.7 Moduł radia

Implementuje łamigłówkę opartą na dekodowaniu alfabetu Morse’a i strojeniu czę-

stotliwości radiowej. Na module prezentowany jest sygnał nawigacyjny w postaci

migającej diody LED wysokiej jasności, odwzorowującej rytm kodu Morse’a. Za-

daniem gracza jest odsłuchanie i rozkodowanie sekwencji sygnałów w celu ustalenia

słowa kluczowego, a następnie odszukanie powiązanej z nim częstotliwości nadajnika

w materiałach referencyjnych i wybranie jej za pomocą inkrementalnego enkodera

obrotowego. Poprawne dostrojenie transpondera kończy zagadkę.

Koordynację wszystkich systemów modułu — odświeżania ekranu, obsługi en-

kodera oraz generowania sygnałów świetlnych — realizuje funkcja gameLoop(). Jest

ona wywoływana asynchronicznie przez bibliotekę komunikacyjną, co pozwala na

zachowanie responsywności węzła przy jednoczesnym wykonywaniu logiki gry.

Listing 4.15 pokazuje kolejność wywołań funkcji odpowiedzialnych za logikę mo-

dułu radiowego.

1 | void gameLoop () {
2 | // Pierwszorz ędne odświe ż enie ekranu po inicjalizacji gry
3 | if ( needsInitialRender ) {
4 | updateDisplay () ;
5 | needsInitialRender = false ;
6 | }
7 | handleEncoder () ; | // Obs ługa strojenia czę stotliwo ści
8 | handleButton () ; | // Weryfikacja naci śnięcia przycisku
| zatwierdzenia
9 | handleMorseCode () ; | // Asynchroniczne generowanie kodu Morse ’a
| na diodzie LED
10 | }

Listing 4.15. Główna pętla logiczna modułu radiowego (Radio.ino)

Zastosowany model programowania opiera się na maszynie stanów i nieblokują-

cych licznikach millis(), dzięki czemu animacja diody LED nie wstrzymuje pracy

procesora. Kluczowym wyzwaniem implementacyjnym była optymalizacja pamięci

SRAM, na którą duży wpływ ma sterownik wyświetlacza OLED (rezerwujący dy-

namicznie 1024 bajty na bufor ramki). Aby uniknąć przepełnienia stosu, wszystkie

definicje słów i częstotliwości zostały przeniesione do nieulotnej pamięci programu.

Listing 4.16 prezentuje strukturę danych RadioTarget oraz deklaracje PROGMEM

użyte do oszczędzania pamięci SRAM.

1 | const char m_0 [] PROGMEM = " | -.. . -..";
2 | // [...]
3 | const char m_15 [] PROGMEM = " -... . . - - ...";

4
5 | struct RadioTarget {
6 | uint16_t freq ; | // Czę stotliwo ść docelowa nadajnika (np.

3505 dla 3.505 MHz )

7 | const char * morse ; | // Wska źnik do ciągu znak ów w pami ęci Flash
8 | };

9
10 | const RadioTarget targets [] = {
11 | {3505 , m_0 } , | // shell
12 | // [...]
13 | {3608 , m_15 } | // beats
14 | };

Listing 4.16. Deklaracja haseł telegraficznych i częstotliwości w pamięci Flash (Radio.ino)

# 5 Testy i działanie systemu

Niniejszy rozdział zawiera szczegółową ocenę systemu z dwóch perspektyw: analizy

ograniczeń zasobów sprzętowych mikrokontrolerów ATmega328P oraz empirycznej weryfikacji poprawności komunikacji I²C, niezawodności logiki modułów i precyzji

odmierzania czasu. Obydwie części uzupełniają się wzajemnie — pierwsze sekcje

pokazują, w jakich warunkach pracy operuje system, podczas gdy testy demonstrują

spełnienie wymagań funkcjonalnych bez przekroczenia limitów sprzętowych.

Specyfika mikrokontrolerów AVR wymusza odmienną metodykę testowania niż

w przypadku klasycznych komputerów. Podstawową weryfikacją jest pomyślna kom-

pilacja kodu, która sprawdza nie tylko składnię, ale i zajętość pamięci Flash oraz

SRAM — raporty kompilatora pozwalają wstępnie upewnić się, że program będzie

mieścił się w dostępnych limitach. Dodatkowo, do podglądu komunikatów diagno-

stycznych w czasie rzeczywistym wykorzystywano płytkę Arduino Uno R4 WiFi jako przekaźnik UART-USB, monitorując stany wewnętrzne (adresy I²C, statusy

modułów, pomiary czasu). Uzupełnieniem weryfikacji kompilacyjnej były testy in-

tegracyjne przeprowadzone na fizycznym prototypie, obejmujące zarówno walidację wydajności kanału I²C, jak i pomiary rzeczywistego zużycia pamięci w warunkach

operacyjnych.

## 5.1 Analiza wykorzystania zasobów sprzętowych

Wybór 8-bitowego mikrokontrolera ATmega328P jako platformy bazowej narzucił

rygorystyczne wymagania dotyczące optymalizacji kodu. Poniższa tabela (Tabe-

la 5.1) zestawia ostateczne wyniki kompilacji dla wszystkich komponentów systemu,

obrazując stopień wykorzystania dostępnej pamięci Flash oraz SRAM.

Tabela 5.1. Zestawienie wykorzystania pamięci mikrokontrolerów ATmega328P

Moduł | Flash [B] | Flash [%] | SRAM [B] | SRAM [%]
Moduł nadrzędny | 10106 | 31% | 964 | 47%
Moduł radiowy | 15326 | 47% | 1716* | 84%

Kontynuacja na następnej stronie

Tabela 5.1 – kontynuacja z poprzedniej strony

Moduł | Flash [B] | Flash [%] | SRAM [B] | SRAM [%]
Moduł labiryntu | 28234 | 87% | 1816* | 89%
Moduł sekwencyjny | 7812 | 24% | 480 | 23%
Moduł arytmetyczny | 9344 | 28% | 692 | 33%
Moduł z przełącznikiem | 5452 | 16% | 545 | 26%

* Wartość uwzględniająca 1024 bajty bufora ramki obrazu alokowanego dynamicznie w pamięci

SRAM przez bibliotekę graficzną, niewidocznego w statystykach kompilacji.

Największe wyzwanie pod kątem zasobów Flash stanowił moduł labiryntu, co wynika z konieczności przechowywania licznych map bitowych renderowanych w perspektywie 3D. Natomiast w przypadku pamięci SRAM kluczowym ograniczeniem okazała się obecność wyświetlaczy OLED w modułach radiowym oraz labiryntu. Powyższa analiza (Tabela 5.1) uwzględnia fakt, że sterowniki graficzne (np. Adafruit_SH1106G) rezerwują w czasie działania programu dodatkowy bufor ramki o rozmiarze 1024 bajtów (128x64 pikseli monochromatycznych). Ponieważ alokacja

ta odbywa się dynamicznie wewnątrz klasy sterownika, nie jest ona raportowana przez kompilator jako stałe zużycie pamięci operacyjnej. W rzeczywistości, po doliczeniu tego bufora, moduł labiryntu operuje na granicy stabilności sprzętowej, wykorzystując blisko 90% dostępnej pamięci SRAM (2 KB), co wymusiło rezygnację z

jakichkolwiek innych struktur dynamicznych i oparcie logiki wyłącznie na zmiennych lokalnych oraz stałych PROGMEM.
Warto również zauważyć, że relatywnie wysokie użycie pamięci Flash w module radiowym (47%) wynika z przechowywania sekwencji alfabetu Morse’a w postaci czytelnych ciągów znaków (np. kropki i kreski jako typ danych char). Rozwiązanie

to wybrano ze względu na przejrzystość kodu i łatwość wprowadzania zmian. W przypadku konieczności dalszej optymalizacji, zasoby te można by zredukować poprzez zastosowanie kodowania bitowego (bit-packing), gdzie każda kropka i kreska

reprezentowana byłaby przez pojedynczy bit, jednak przy obecnej skali projektu nie było to wymagane.

## 5.2 Weryfikacja systemu poprzez testy i pomiary

Poniższe sekcje prezentują wyniki empirycznej weryfikacji warstwy sprzętowej i komunikacyjnej systemu. Przeprowadzone scenariusze testowe obejmują walidację kluczowych parametrów funkcjonalnych (stabilność protokołów I²C, obsługa błędów, precyzja timera), a następnie analizę wydajności systemu na podstawie szczegóło-

wych logów z testów operacyjnych.

### 5.2.1 Wyniki testów sprzętowych

Tabela 5.2. Wyniki testów sprzętowych systemu modularnego

Oznaczenie | n | Opis scenariusza
T01 | 10 | Powtarzalność inicjalizacji systemu oraz automatycznej detekcji węzłów na magistrali I²C.
T02 | 10 | Weryfikacja mechanizmu obsługi błędów pojedynczego modułu i propagacja stanu do pozostałych węzłów sieci.
T03 | 5 | Weryfikacja warunku zakończenia sesji.
T04 | 5 | Weryfikacja procedury przekroczenia czasu.

Tabela 5.2 zawiera podsumowanie przeprowadzonych scenariuszy testowych oraz krótką charakterystykę każdego testu.

Test T01: Powtarzalność procesu inicjalizacji

Celem testu była weryfikacja stabilności procedury automatycznej adresacji i wykrywania modułów na magistrali I²C. Przeprowadzono 10 cykli zimnego startu systemu,

monitorując poprawność identyfikacji wszystkich urządzeń peryferyjnych przez jednostkę centralną (Master). Wszystkie próby przebiegły pomyślnie — każdy moduł

udzielił potwierdzenia ACK w odpowiedzi na ramkę CMD_IDENTIFY, a po uruchomieniu systemu wszystkie jednostki zgłosiły gotowość do pracy.

Test T02: Obsługa stanów awaryjnych

W ramach testu sprawdzono zdolność jednostki Master do rejestracji i dystrybucji zmiennej stanu błędu (mistakeCount) po wystąpieniu zdarzenia STATUS_FAILED w

dowolnym module. Wszystkie testy przebiegły pomyślnie, a system poprawnie zareagował na symulowane błędy, aktualizując stan globalny i przekazując informację do pozostałych modułów.

Test T03: Weryfikacja warunku zakończenia sesji

Weryfikacji poddano warunek zakończenia sesji, polegający na zgłoszeniu statusu PASS przez wszystkie aktywne moduły. W 5 przeprowadzonych próbach system każdorazowo pozostawał w stanie oczekiwania na potwierdzenie ostatniego modułu przed zadeklarowaniem zakończenia sesji.

Test T04: Weryfikacja procedury przekroczenia czasu

Badanie miało na celu zweryfikowanie poprawności działania mechanizmu zakończenia sesji oraz ilościowe określenie odchyleń pomiaru czasu. W pięciu przeprowadzonych próbach zaobserwowano odchylenia czasu w zakresie 2–6 s względem czasu referencyjnego.

### 5.2.2 Analiza wydajności i częstotliwości komunikacji

Charakteryzacja pełnego działania systemu wymaga szczegółowej analizy wydajności i intensywności komunikacji I²C. Przeprowadzono analizę danych zbieranych

przez system w trakcie 300-sekundowych przebiegów testowych. W ramach trzech niezależnych przebiegów testowych zebrano po 61 pięciosekundowych fragmentów danych w każdym (razem 183), umożliwiając ocenę granularnych metryk dotyczą-

cych częstotliwości opytania modułów, czasów odkrywania i ogólnej reaktywności systemu. W Tabeli 5.3 zestawiono kluczowe parametry pomiarów.

Tabela 5.3. Metryki wydajności systemu I²C i pętli głównej

Parametr | Wartość | Jednostka
Średni czas wykrywania modułów | 115 | ms
Liczba odpytań w 5 sekund | 434 | zapytań
Średnia częstotliwość odpytań | 86,8 | Hz (całkowita)
Średnia częstotliwość na moduł | 17,36 | Hz
Średni okres cyklu opytania na moduł | 57,6 | ms

Przebieg liczby odpytań w kolejnych seriach pomiarowych pokazany na Rysunku 5.1 potwierdza, że system utrzymuje stałą wartość około 435 odpytań na próbkę (5 sekund) z okazjonalnymi wahaniami do 420, co odzwierciedla stabilność mechanizmu opytania magistrali I²C.


Rysunek 5.1. Przebieg liczby odpytań modułów w kolejnych seriach pomiarowych

Pomiary wykazują, że system utrzymuje stałą częstotliwość odpytania każdego z modułów na poziomie 17 Hz, co odpowiada okresowi cyklu około 57–58 ms. Czas odkrywania modułów na magistrali I²C wynoszący średnio 115 ms jest akceptowalny

dla zastosowania o charakterze interaktywnym, gdzie elementy interfejsu aktualizują się co kilkaset milisekund. Wynik ten potwierdza efektywność implementacji procedury discoverModules() w kodzie modułu nadrzędnego.

# 6 Podsumowanie i wnioski końcowe

Projekt systemu i przeprowadzone testy umożliwiły pomyślną realizację głównego celu pracy, jakim było zaprojektowanie i wdrożenie modularnego systemu zadań logicznych opartego na mikrokontrolerach ATmega328P. Opracowane rozwiązanie obejmuje jednostkę nadrzędną, pięć niezależnych modułów oraz warstwę komunikacyjną opartą na magistrali I²C. Uzyskane wyniki potwierdziły poprawność przyjętej

architektury, stabilność działania logiki modułów oraz skuteczność automatycznej detekcji i synchronizacji urządzeń w ramach jednej, spójnej topologii.
Warto podkreślić, że system został zweryfikowany w ściśle określonych scenariuszach testowych i w granicach możliwości sprzętowych platformy ATmega328P. Największe wyzwania dotyczyły stabilności komunikacji na magistrali I²C oraz ogra-

niczeń pamięci SRAM, szczególnie w przypadku modułu labiryntu. Dodatkowym ograniczeniem była trudność w przeprowadzeniu prostych, pełnych symulacji całego układu, dlatego kluczowe znaczenie miały testy wykonywane na rzeczywistym prototypie. Wymusiło to konsekwentną optymalizację kodu, ograniczenie wykorzystania struktur dynamicznych oraz szerokie zastosowanie pamięci Flash, jednak przyjęte rozwiązania okazały się wystarczające do zapewnienia poprawnej i responsywnej pracy całego systemu.
Wyniki badań przedstawione w rozdziale 5 potwierdzają wysoką powtarzalność i poprawność działania systemu. W testach inicjalizacji (T01) każdorazowo uzyskiwano poprawną detekcję modułów oraz potwierdzenia ACK na magistrali I²C,

co potwierdza niezawodność procedury startowej. Test obsługi stanów awaryjnych (T02) wykazał poprawną propagację informacji o błędzie i spójne aktualizowanie stanu globalnego, a scenariusz zakończenia sesji (T03) potwierdził, że logika nad-

rzędna prawidłowo oczekuje na spełnienie kompletnego warunku ukończenia gry. Istotnym wnioskiem praktycznym jest również stabilność czasowa i komunikacyjna układu. Pomiary wydajności wykazały średni czas wykrywania modułów na poziomie 115 ms oraz utrzymywanie częstotliwości odpytywania około 17 Hz na moduł, co zapewnia płynną i przewidywalną reakcję systemu. Jednocześnie odchylenia pomiaru czasu obserwowane w teście przekroczenia limitu czasowego (T04)

pozostawały w ograniczonym zakresie 2-6 s, co przy zastosowanej klasie sprzętu i charakterze interaktywnej rozgrywki należy uznać za wynik akceptowalny.
W przyszłości system mógłby zostać rozbudowany o kolejne moduły oraz o dodatkowe mechanizmy ułatwiające konfigurację i nadzór nad rozgrywką. Cennym kierunkiem dalszych prac byłaby również aktualizacja i powtórzenie badań po dłuższym czasie eksploatacji, aby ocenić trwałość przyjętych rozwiązań oraz ich podatność na dalszą rozbudowę. Możliwe byłoby także przeniesienie części funkcji na wydajniejszą platformę, na przykład mikrokontroler ESP32, a w szerszej perspektywie uzupełnienie systemu o komunikację bezprzewodową, zdalną administrację lub nowe moduły wykorzystujące bardziej zaawansowane mechanizmy interakcji.

# Bibliografia

[1] Microchip | Technology | Inc., | ATmega328P | 8-bit | AVR | Mi-
crocontroller | Datasheet, | Specyfikacja | techniczna | (Datashe-
et), | https://ww1.microchip.com/downloads/en/DeviceDoc/

Atmel-7810-Automotive-Microcontrollers-ATmega328P_Datasheet.pdf. (https://ww1.microchip.com/downloads/en/DeviceDoc/Atmel-7810-Automotive-Microcontrollers-ATmega328P_Datasheet.pdf)

[2] Arduino, Arduino Language Reference (C++), Dokumentacja języka i struktury programowania środowiska Arduino IDE, opartego o C/C++, https://www.

arduino.cc/reference/en/.

[3] Arduino, LiquidCrystal Library - API Documentation, Biblioteka referencyjna obsługi wyświetlaczy alfanumerycznych LCD (standard HD44780), https://

www.arduino.cc/reference/en/libraries/liquidcrystal/.

[4] Arduino, Wire Library - API Documentation, Biblioteka referencyjna rdzenia sprzętowego komunikacji TWI/I²C interfejsów standardu Ar-
duino, | https://www.arduino.cc/reference/en/language/functions/

communication/wire/. (https://www.arduino.cc/reference/en/language/functions/communication/wire/)

[5] Limor Fried, Adafruit Industries, Adafruit SH110X Library, Wersja 2.1.8,

Zoptymalizowany dla modułów macierzy węzłów, https://github.com/

adafruit/Adafruit_SH110x. (https://github.com/adafruit/Adafruit_SH110x)

[6] Adafruit Industries, Adafruit GFX Library, Rdzeń procedur rysowania struktur 2D w środowisku mikrokontrolerów dla ekranów LCD/OLED, https:

//github.com/adafruit/Adafruit-GFX-Library.

[7] Avishay Orpaz, TM1637Display, Driver wyświetlaczy podłączanych po magi-

strali 2-wire, https://github.com/avishorp/TM1637.

[8] Stroustrup B., Język C++. Kompendium wiedzy, wyd. IV, Helion, Gliwice 2014,

ISBN: 978-83-283-8329-6.

[9] Mahmutbegović A., C++ w systemach wbudowanych. Skuteczna migracja z C

do nowoczesnego C++, Helion, Gliwice 2026. ISBN: 978-83-289-3561-7.

[10] Bancila M., Nowoczesny C++. Zbiór praktycznych zadań dla przyszłych eksper-

tów, Helion, Gliwice 2019, ISBN: 978-83-283-5211-7.

[11] Josuttis N. M., C++ Biblioteka standardowa. Podręcznik programisty, wyd. II,

Helion, Gliwice 2014. ISBN: 978-83-246-5576-2.

[12] Weisfeld M., Myślenie obiektowe w programowaniu. Wydanie V, Helion, Gliwice

2020, ISBN: 978-83-283-6104-1.

[13] Guntheroth K., C++ Optymalizacja kodu, Helion, Gliwice 2017, ISBN (ebook):

978-83-754-1337-3.

[14] Blum J., Odkrywanie Arduino. Narzędzia i techniki inżynierii pełnej czaru, wyd.

II, Helion, Gliwice 2020, ISBN: 978-83-283-6924-5.

[15] Francuz T., Mikrokontrolery AVR i ARM. Sterowanie wyświetlaczami LCD,

Helion, Gliwice 2017, ISBN: 978-83-283-2846-4.

# Spis rysunków

3.1 Diagram klas biblioteki ModuleComms — relacja Master-Slave z pro-
tokołem komunikacyjnym (opracowanie własne) | 22

3.2 Diagram klas modułów zagadek z wewnętrznymi typami wyliczenio-
wymi i strukturami danych (opracowanie własne) | 23

3.3 Diagram zależności warstwy sprzętowej — powiązania modułów z bi-
bliotekami zewnętrznymi (opracowanie własne) | 25

5.1 Przebieg liczby odpytań modułów w kolejnych seriach pomiarowych . 51

# Spis tabel

5.1 Zestawienie wykorzystania pamięci mikrokontrolerów ATmega328P . 47
