StanislawStankiewicz/DefuseIt/Cables/IMG_20250220_000421.jpg

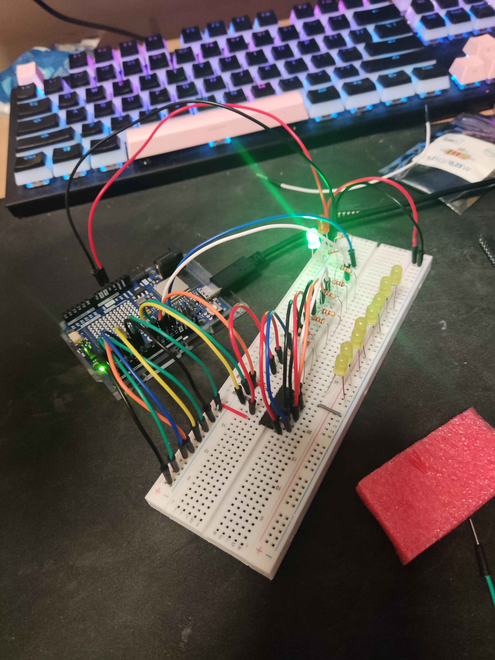
Cables/IMG_20250220_000421.jpg
