StanislawStankiewicz/DefuseIt/Master/IMG_20250225_014531.jpg

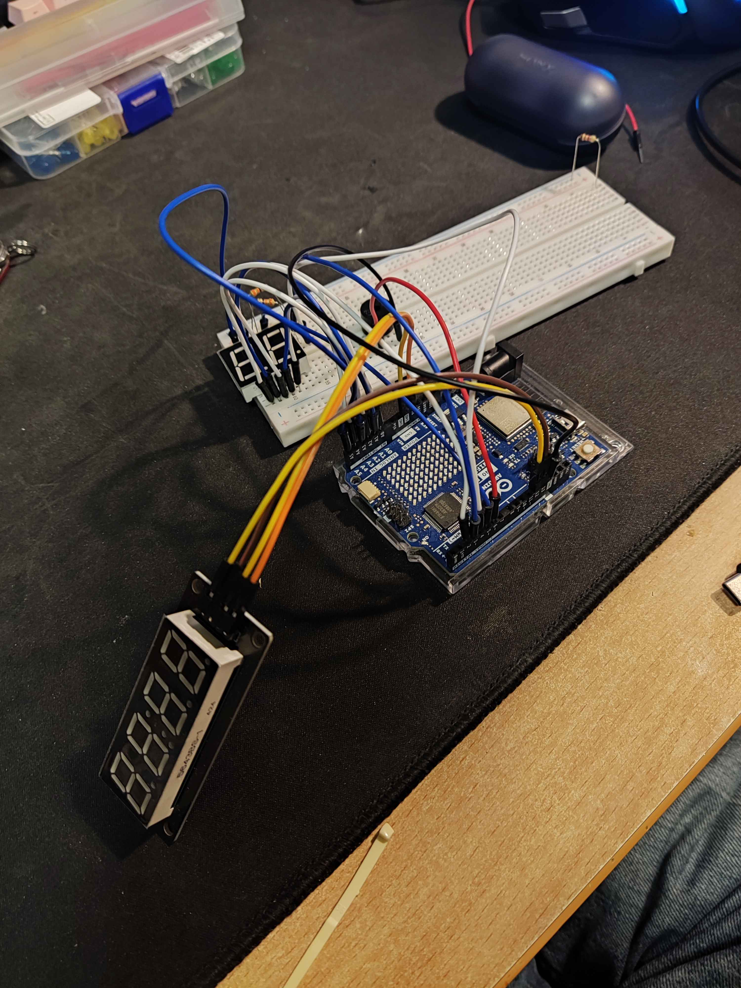
Master/IMG_20250225_014531.jpg
