StanislawStankiewicz/DefuseIt/thesis/logs/testlogs_analysis_plots.png

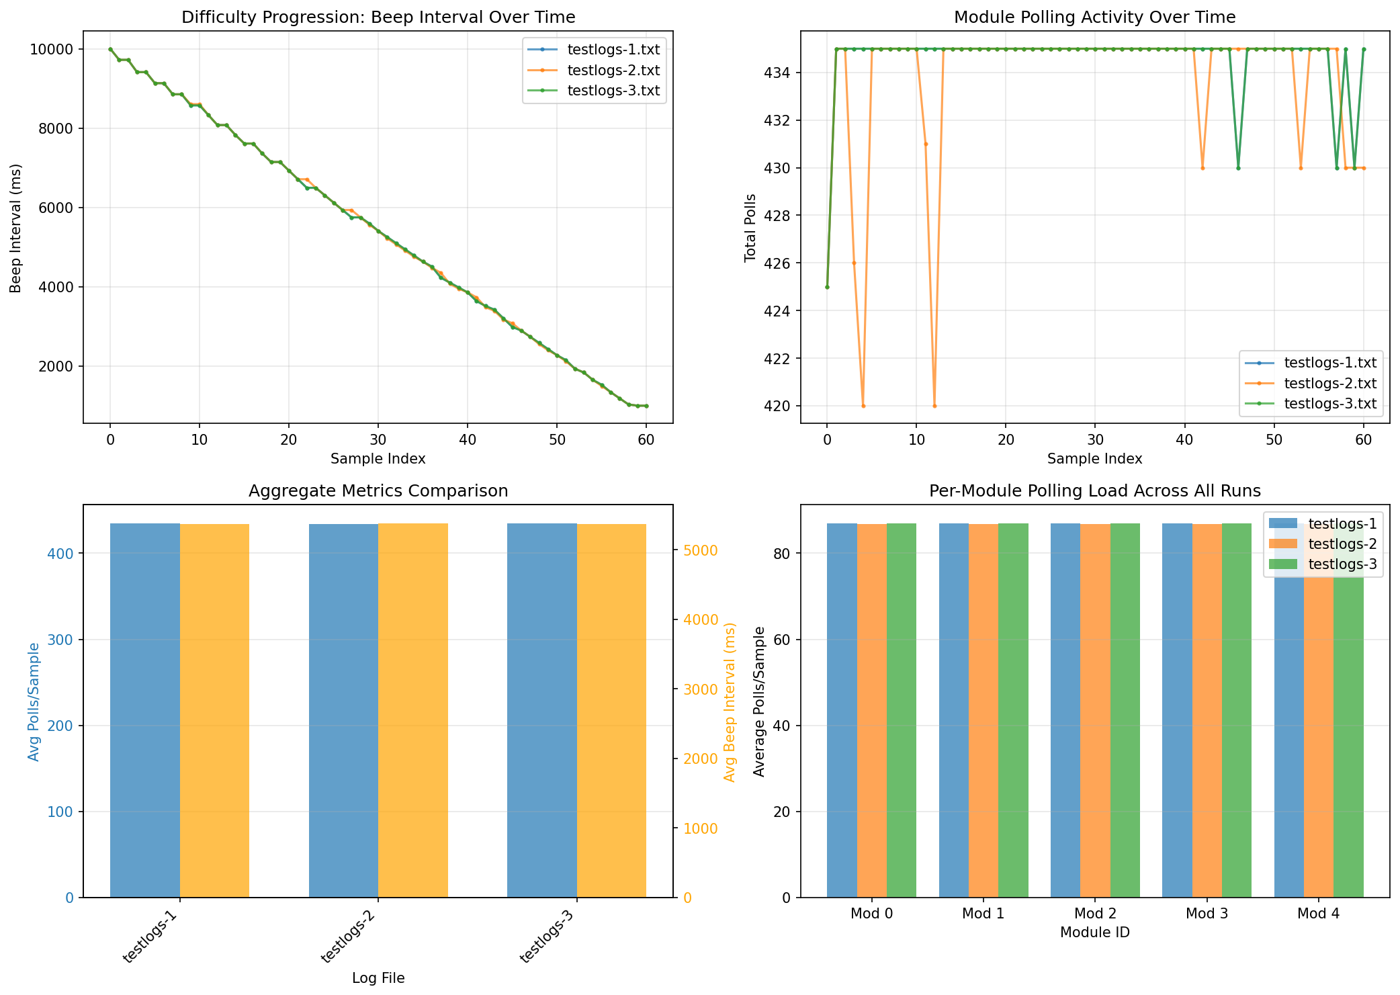
thesis/logs/testlogs_analysis_plots.png
