StanislawStankiewicz/DefuseIt/ModulesTest/slave1/slave1.ino

#include <Wire.h>
#include "ModuleComms.h"

#define BUTTON_PIN 2
#define LED_PIN 3

// Function prototypes
void gameLoop();
void resetState();

Slave slave(0x10, gameLoop, resetState, LED_PIN);
bool isSolved = false;

void resetState() {
    isSolved = false;
}

void setup() {
    Serial.begin(9600);
    Serial1.begin(9600);  // For forwarding Master's Serial output
    Serial.println("Slave 1: initializing with Serial bridge");
    pinMode(BUTTON_PIN, INPUT_PULLUP);
    pinMode(9, OUTPUT);
    digitalWrite(9, HIGH);
    
    slave.begin();
}

void gameLoop() {
    if (!isSolved && digitalRead(BUTTON_PIN) == LOW) {
        Serial.println("Slave 1: Solved!");
        slave.pass();
        isSolved = true;
    }
}

void loop() {
    // Forward Master's Serial output to PC
    while (Serial1.available()) {
        char c = Serial1.read();
        Serial.write(c);
    }

    // Handle I2C slave functionality
    slave.slaveLoop();
}
