StanislawStankiewicz/DefuseIt/(commit log)

2025-02-19 add labyrinth and kicad base project
    [Ketane.kicad_pcb, Ketane.kicad_sch]
2025-02-19 add Cables
2025-02-28 add i2c test files
2025-02-28 rework master to add i2c
    [master.ino]
2025-03-03 add i2c to master, remove kicad files
    [Ketane.kicad_pcb, Ketane.kicad_sch]
2025-03-27 change screen to use spi instead of i2c
2025-10-28 add a switch functionality to turn the game on and off
2025-12-01 Refactor game state management and module initialization
    - Removed redundant module initialization from setup() in Master.ino.
    - Moved module initialization to startGame() to ensure proper state management.
    - Updated Slave class to use resetState() instead of setInitialState() for better clarity.
    - Adjusted status codes in ModuleComms.h for consistency.
    - Added a new MasterSerial.ino sketch for testing the master controller via Serial.
    - Implemented a new Symbols module to control multiple OLED displays through an I2C multiplexer.
    - Enhanced SimonSays module to improve button handling and state management.
    - Created a mux_test sketch for testing the OLED multiplexer functionality.
    - Updated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
    [Keypad.ino, MasterSerial.ino, ModuleComms.cpp, ModuleComms.h, SerialEcho.ino, SimonSays.ino, Symbols.ino, slave1.ino]
2026-01-06 refactor: streamline OLED and button handling in Labyrinth module
2026-02-12 refactor: update time synchronization module address and enhance color handling logic in Switch module
2026-02-15 refactor: enhance keypad debouncing logic and add mistake handling in game modules
    [Keypad.ino, Labyrinth.ino, Master.ino, ModuleComms.cpp, ModuleComms.h, Radio.ino, SimonSays.ino, Symbols.ino]
2026-03-15 change button mapping based on the number of mistakes
    [SimonSays.ino]
2026-05-06 Initialize switch state in setup and enhance feedback logic in SimonSays
2026-05-09 Update I2C slave addresses for Labyrinth, Radio, and Switch modules
2026-05-09 Fix LED being turned on on setup
    [Switch.ino]
2026-05-09 Fix button press validation to account for mistakes
    [SimonSays.ino]
